angrywasp/Modbot.Tank/README.md

# Modbot.Tank
Project to build an RC tank based on the Modbot system
