angrywasp/Modbot.Tank/Models/Export/BatteryHolder.stl

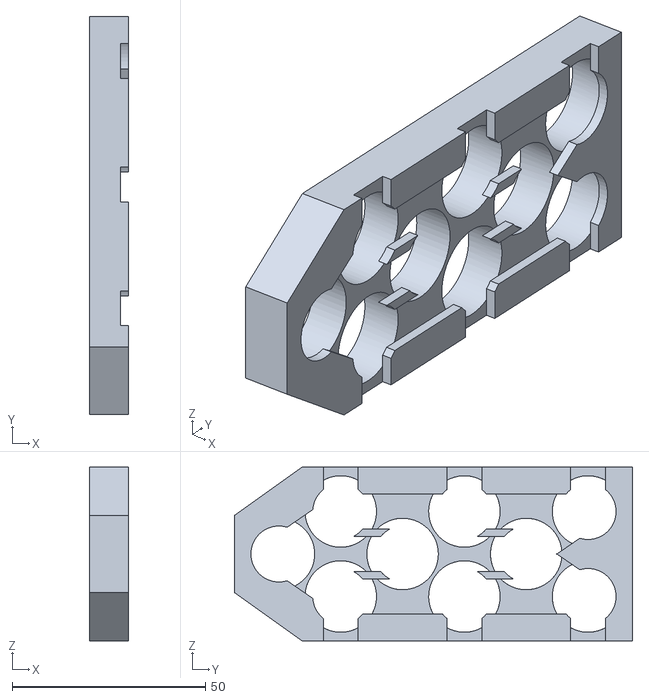
[picture p1: CAD file, 2026-05-19]
Models/Export/BatteryHolder.stl
10.0 x 103.0 x 45.0
