angrywasp/Modbot.Tank/Models/Export/TransmitterBody.stl

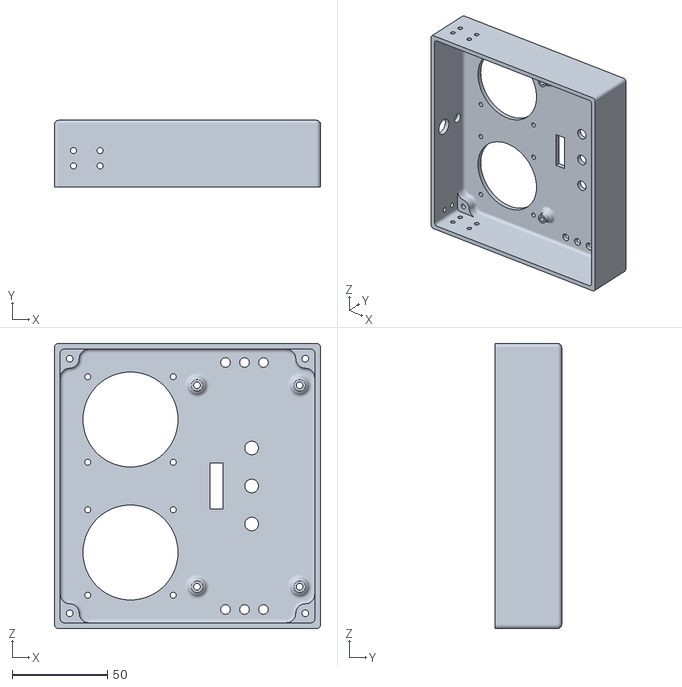
[picture p2: CAD file, 2026-05-19]
Models/Export/TransmitterBody.stl
140.0 x 35.0 x 150.0
