angrywasp/Modbot.Tank/Models/Export/ESPDevBoard.stl

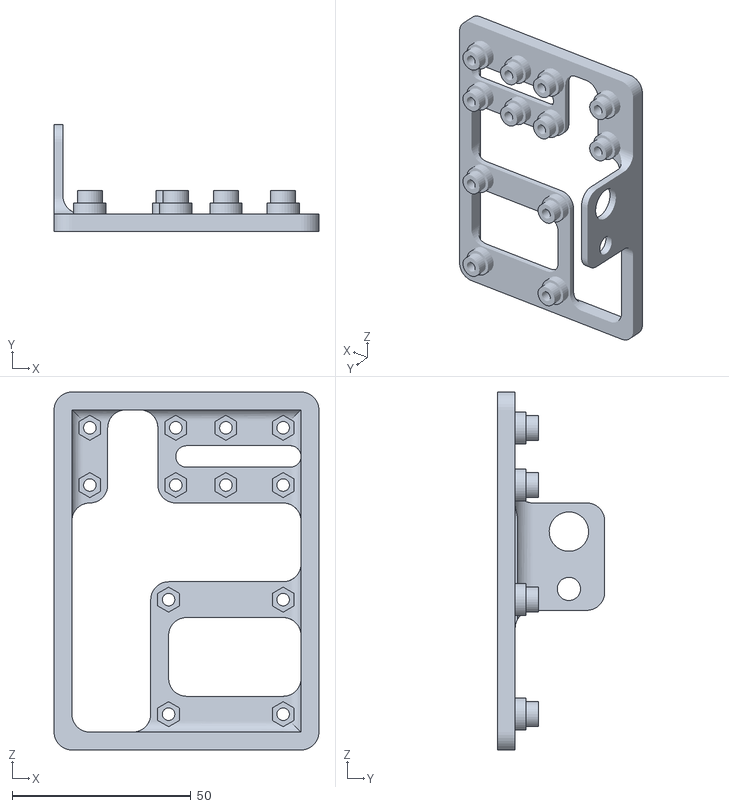
[picture p3: CAD file, 2026-05-19]
Models/Export/ESPDevBoard.stl
74.0 x 30.0 x 100.0
