angrywasp/Modbot.Tank/Models/Export/NrfMount.stl

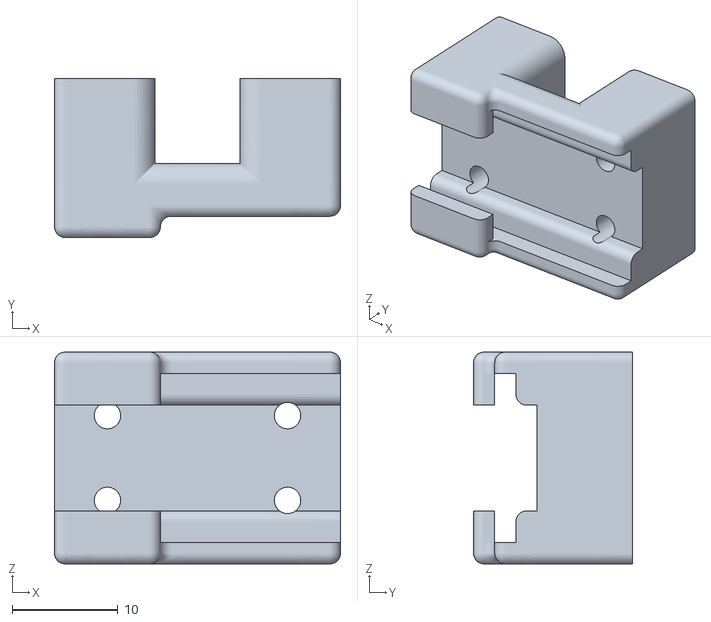
[picture p4: CAD file, 2026-05-19]
Models/Export/NrfMount.stl
27.0 x 15.0 x 20.0
