angrywasp/Modbot.Tank/Models/Export/TransmitterBack.stl

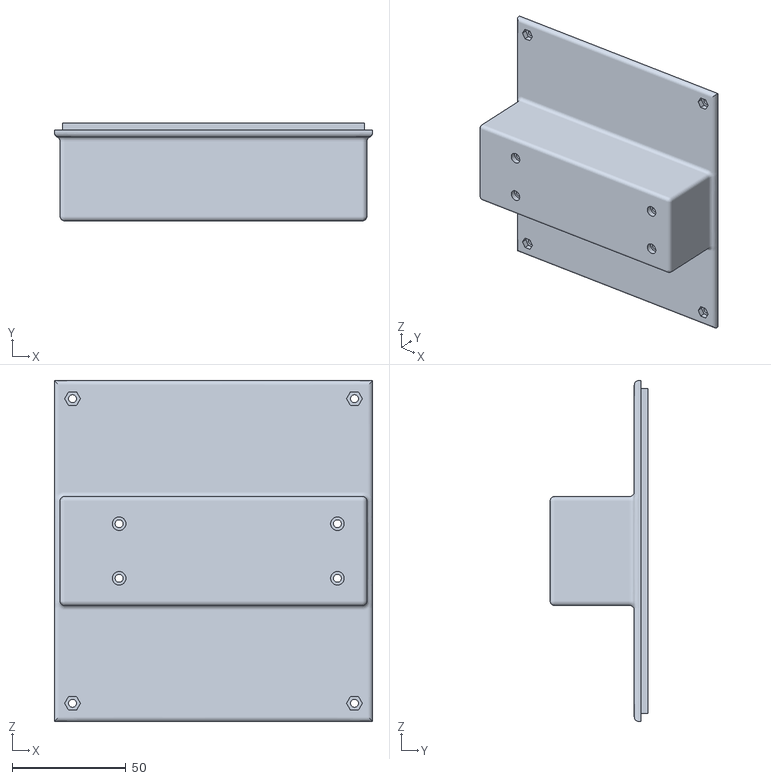
[picture p5: CAD file, 2026-05-19]
Models/Export/TransmitterBack.stl
140.0 x 43.0 x 150.0
