angrywasp/Modbot.Tank/Models/Export/BatteryHolder2PBase.stl

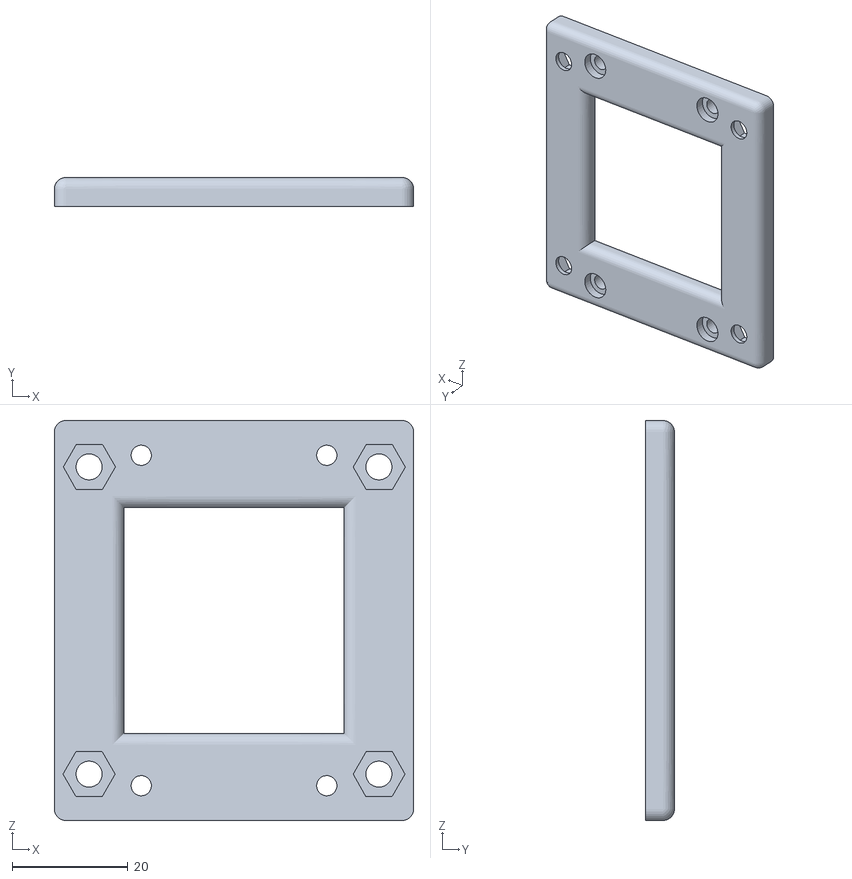
[picture p6: CAD file, 2026-05-19]
Models/Export/BatteryHolder2PBase.stl
62.0 x 5.00 x 69.0
