angrywasp/Modbot.Tank/Models/Export/PcbSpacer3x6mm.stl

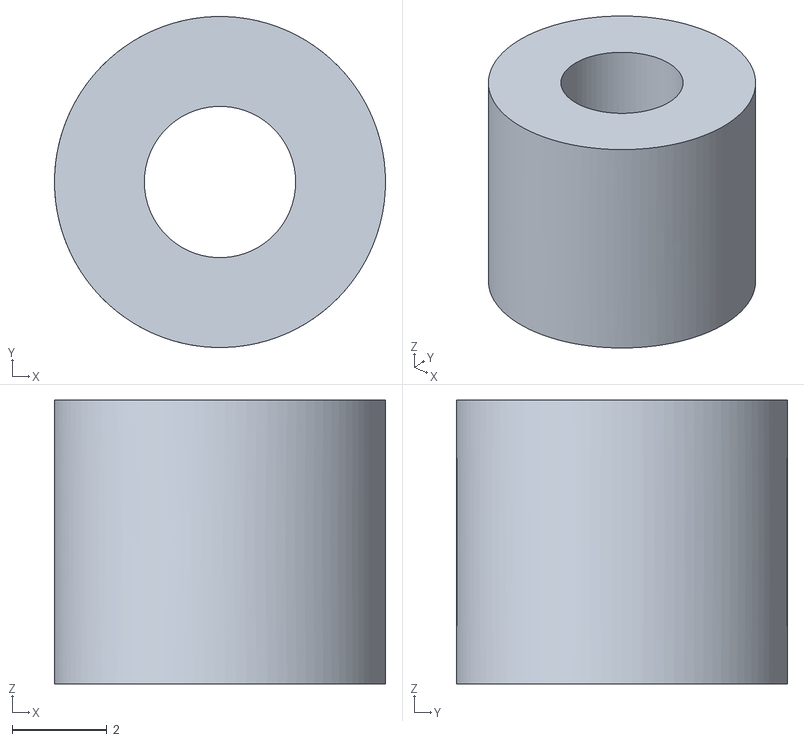
[picture p7: CAD file, 2026-05-19]
Models/Export/PcbSpacer3x6mm.stl
7.00 x 7.00 x 6.00
