angrywasp/Modbot.Tank/Models/Export/PowerBoard.stl

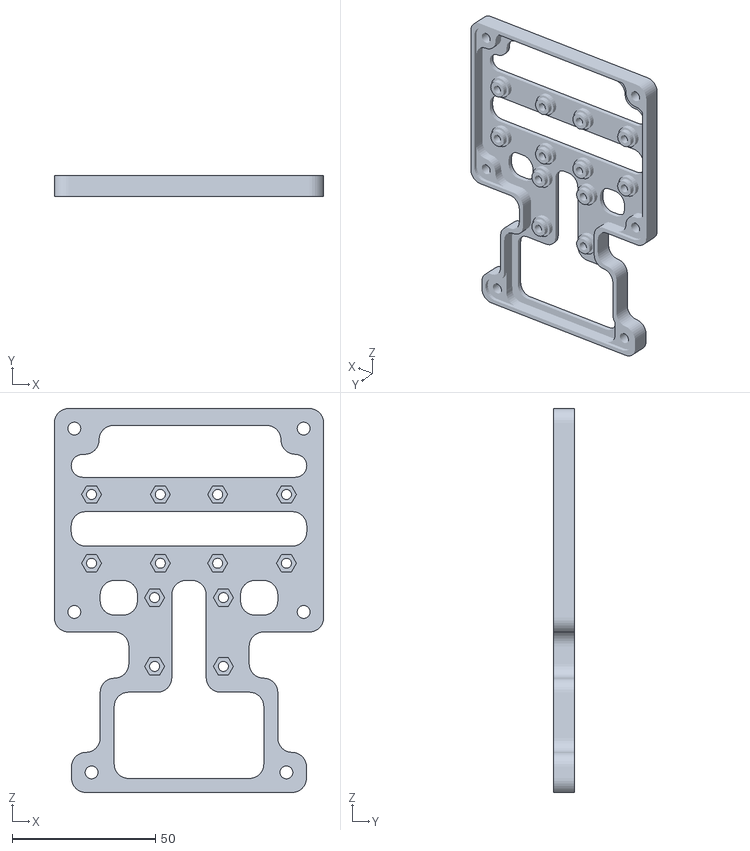
[picture p8: CAD file, 2026-05-19]
Models/Export/PowerBoard.stl
94.0 x 7.50 x 134.0
