angrywasp/Modbot.Tank/Models/Export/PcbSpacer4x5mm.stl

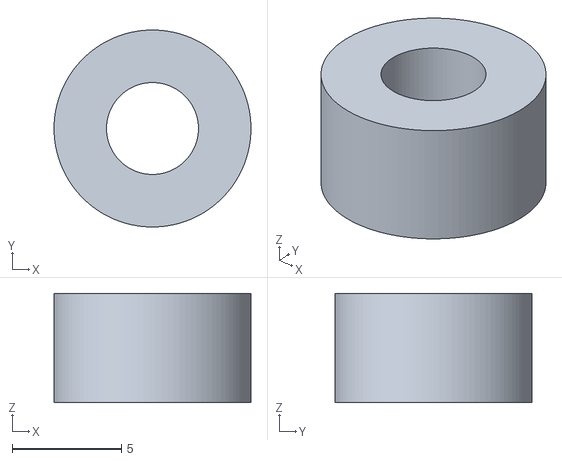
[picture p9: CAD file, 2026-05-19]
Models/Export/PcbSpacer4x5mm.stl
9.00 x 9.00 x 5.00
