angrywasp/Modbot.Tank/Models/Export/BatteryHolder2P.stl

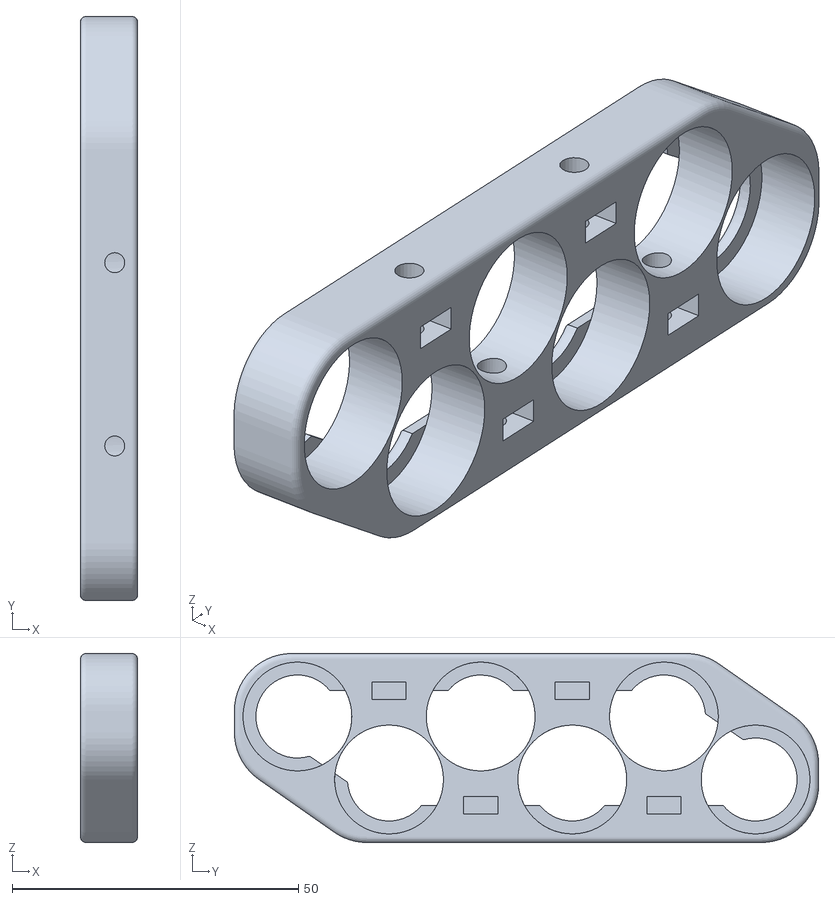
[picture p10: CAD file, 2026-05-19]
Models/Export/BatteryHolder2P.stl
10.0 x 102.0 x 33.0
