angrywasp/Modbot.Tank/Models/Export/BatteryHolder2PTop.stl

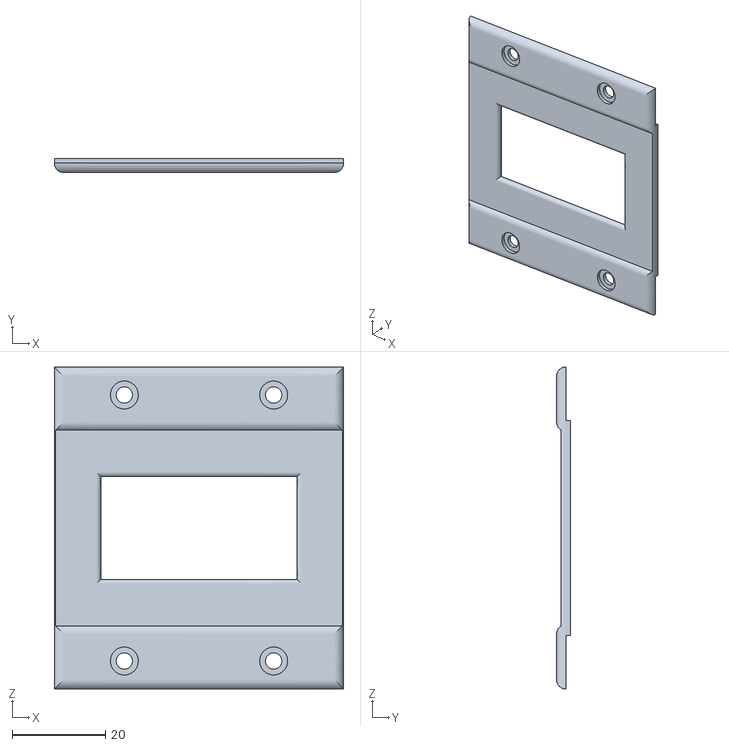
[picture p11: CAD file, 2026-05-19]
Models/Export/BatteryHolder2PTop.stl
62.0 x 3.00 x 69.0
