angrywasp/Modbot.Tank/(list of files, cad)

Other CAD files:
Models/AntennaMast.ipt
Models/AntennaMast65mm.ipt
Models/AntennaMast80mm.ipt
Models/AntennaMount.ipt
Models/BatteryHolder2P.ipt
Models/BatteryHolder2PBase.ipt
Models/BatteryHolder2PTop.ipt
Models/ESPDevBoard.ipt
Models/FpvBoardMount.ipt
Models/FpvScreenMount.ipt
Models/NrfMount.ipt
Models/PanTiltMount.ipt
Models/PcbSpacer3x3mm.ipt
Models/PcbSpacer3x6mm.ipt
Models/PcbSpacer4x20mm.ipt
Models/PcbSpacer4x5mm.ipt
Models/PowerBoardMount.ipt
Models/PowerPlugMountSlim.ipt
Models/RxBoardMount.ipt
Models/RxBoardMountFoot.ipt
Models/RxBoardMountFootWithNut.ipt
Models/SwitchMount.ipt
Models/SwitchMountTop.ipt
Models/TransmitterBack.ipt
Models/TransmitterBody.ipt
Models/TxBoardMount.ipt
