angrywasp/Modbot.Tank/Hardware/TxInputBoard/TxInputBoard.kicad_pcb

## KiCad design Hardware/TxInputBoard/TxInputBoard.kicad_pcb (2026-05-19)

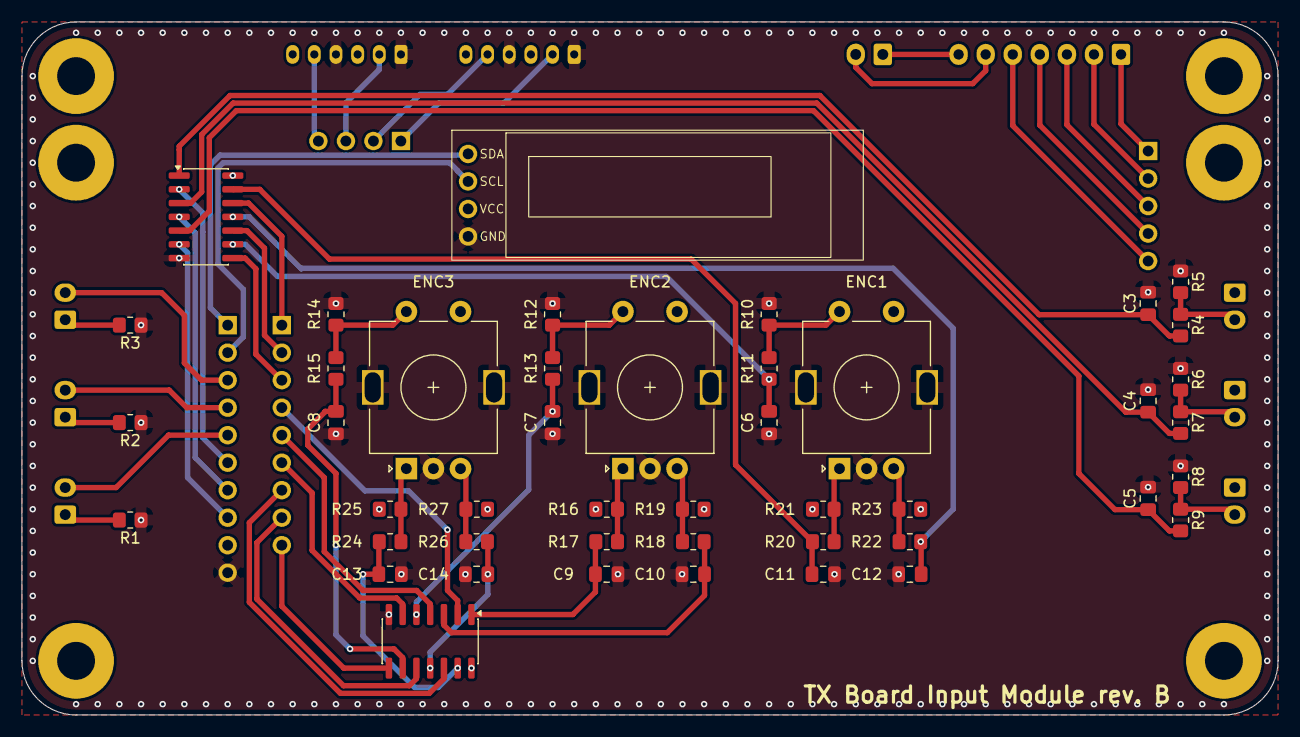
[picture p12: board TxInputBoard.kicad_pcb from above]

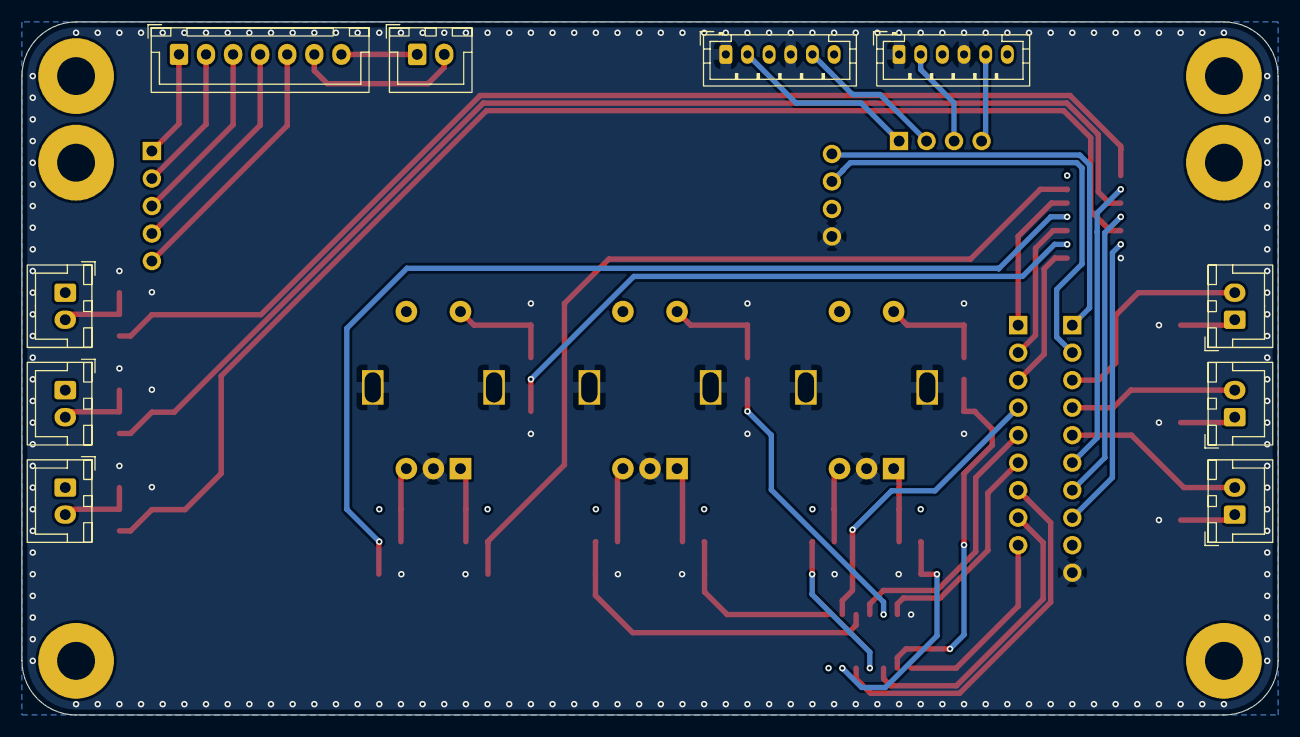
[picture p13: board TxInputBoard.kicad_pcb from below]

Board: 4 copper layers, 116.0 x 64.0 mm, 56 parts (11 on the bottom side), 57 nets.

Parts:
C3, C4, C5, C6, C7, C8, C9, C10, C11, C12, C13, C14: 0.1uF; C_0805_2012Metric_Pad1.18x1.45mm_HandSolder
ENC1, ENC2, ENC3: RotaryEncoder_Switch_MP; RotaryEncoder_Alps_EC11E-Switch_Vertical_H20mm
J4: L Joy; JST_PH_B6B-PH-K_1x06_P2.00mm_Vertical
J5: R Joy; JST_PH_B6B-PH-K_1x06_P2.00mm_Vertical
J8: OLED; SSD1306_OLED_128x32
JSwitch1: Conn_01x02; JST_XH_B2B-XH-A_1x02_P2.50mm_Vertical
L1, L2, L3: Green; JST_XH_B2B-XH-A_1x02_P2.50mm_Vertical
R1, R2, R3: 330; R_0805_2012Metric_Pad1.20x1.40mm_HandSolder
R4, R7, R9, R11, R13, R15: 1k; R_0805_2012Metric_Pad1.20x1.40mm_HandSolder
R5, R6, R8, R10, R12, R14, R16, R17, R18, R19, R20, R21, R22, R23, R24, R25, R26, R27: 10k; R_0805_2012Metric_Pad1.20x1.40mm_HandSolder
SW1, SW2, SW3: SW_SPST; JST_XH_B2B-XH-A_1x02_P2.50mm_Vertical
U1, U2: 74HC14; SO-14_3.9x8.65mm_P1.27mm
U3: MCP73831_18650Charger; JST_XH_B7B-XH-A_1x07_P2.50mm_Vertical
U4: MiniTx; TXBoardMini

Connections:
+3.3V: ENC1.S1, ENC2.S1, ENC3.S1, J4.3, J4.6, J5.3, J5.6, J8.3, R16.2, R19.2, R21.2, R23.2, R25.2, R27.2, SW1.1 (A), SW2.1 (A), SW3.1 (A), U1.14 (VCC), U2.14 (VCC), U4.18 (3v3)
CMP: U3.3 (CMP), U4.22 (CMP)
ENC1_A: U1.12, U4.1 (E1A)
ENC1_B: U1.10, U4.2 (E1B)
ENC1_SW: U1.8, U4.3 (E1SW)
ENC2_A: U2.2, U4.4 (E2A)
ENC2_B: U2.4, U4.5 (E2B)
ENC2_SW: U2.6, U4.6 (E2SW)
ENC3_A: U2.12, U4.7 (E3A)
ENC3_B: U2.10, U4.8 (E3B)
ENC3_SW: U2.8, U4.9 (E3SW)
GND: C3.2, C4.2, C5.2, C6.2, C7.2, C8.2, C9.2, C10.2, C11.2, C12.2, C13.2, C14.2, ENC1.C, ENC1.MP, ENC2.C, ENC2.MP, ENC3.C, ENC3.MP, J4.1, J4.4, J5.1, J5.4, J8.4, R1.1, R2.1, R3.1, R5.1, R6.1, R8.1, R10.1, R12.1, R14.1, U1.7 (GND), U2.7 (GND), U4.19 (GND)
IN+: U3.1 (IN+), U4.20 (IN+)
IN-: U3.2 (IN-), U4.21 (IN-)
LED_1: L1.2 (A), U4.14 (LED1)
LED_2: L2.2 (A), U4.13 (LED2)
LED_3: L3.2 (A), U4.12 (LED3)
LJOY1: J4.2, U4.25 (A1)
LJOY2: J4.5, U4.26 (A2)
unnamed: C3.1, R4.2, U1.1
unnamed: C4.1, R7.2, U1.3
unnamed: C5.1, R9.2, U1.5
unnamed: C6.1, R11.2, U1.9
unnamed: C7.1, R13.2, U2.5
unnamed: C8.1, R15.2, U2.9
unnamed: C9.1, R17.2, U2.1
unnamed: C10.1, R18.2, U2.3
unnamed: C11.1, R20.2, U1.13
unnamed: C12.1, R22.2, U1.11
unnamed: C13.1, R24.2, U2.13
unnamed: C14.1, R26.2, U2.11
unnamed: ENC1.A, R20.1, R21.1
unnamed: ENC1.B, R22.1, R23.1
unnamed: ENC1.S2, R10.2, R11.1
unnamed: ENC2.A, R16.1, R17.1
unnamed: ENC2.B, R18.1, R19.1
unnamed: ENC2.S2, R12.2, R13.1
unnamed: ENC3.A, R24.1, R25.1
unnamed: ENC3.B, R26.1, R27.1
unnamed: ENC3.S2, R14.2, R15.1
unnamed: JSwitch1.1, U3.7 (SW)
unnamed: JSwitch1.2, U3.6 (SW)
unnamed: L1.1 (K), R1.2
unnamed: L2.1 (K), R2.2
unnamed: L3.1 (K), R3.2
unnamed: R4.1, R5.2, SW1.2 (B)
unnamed: R6.2, R7.1, SW2.2 (B)
unnamed: R8.2, R9.1, SW3.2 (B)
OLED_SCL: J8.2, U4.11 (OLED_SCL)
OLED_SDA: J8.1, U4.10 (OLED_SDA)
OUT+: U3.5 (OUT+), U4.24 (OUT+)
OUT-: U3.4 (OUT-), U4.23 (OUT-)
RJOY1: J5.2, U4.27 (A3)
RJOY2: J5.5, U4.28 (A4)
SW1: U1.2, U4.15 (SW1)
SW2: U1.4, U4.16 (SW2)
SW3: U1.6, U4.17 (SW3)
