angrywasp/Modbot.Tank/Hardware/TxBoardMini/TxBoardMini.kicad_pcb

## KiCad design Hardware/TxBoardMini/TxBoardMini.kicad_pcb (2026-05-19)

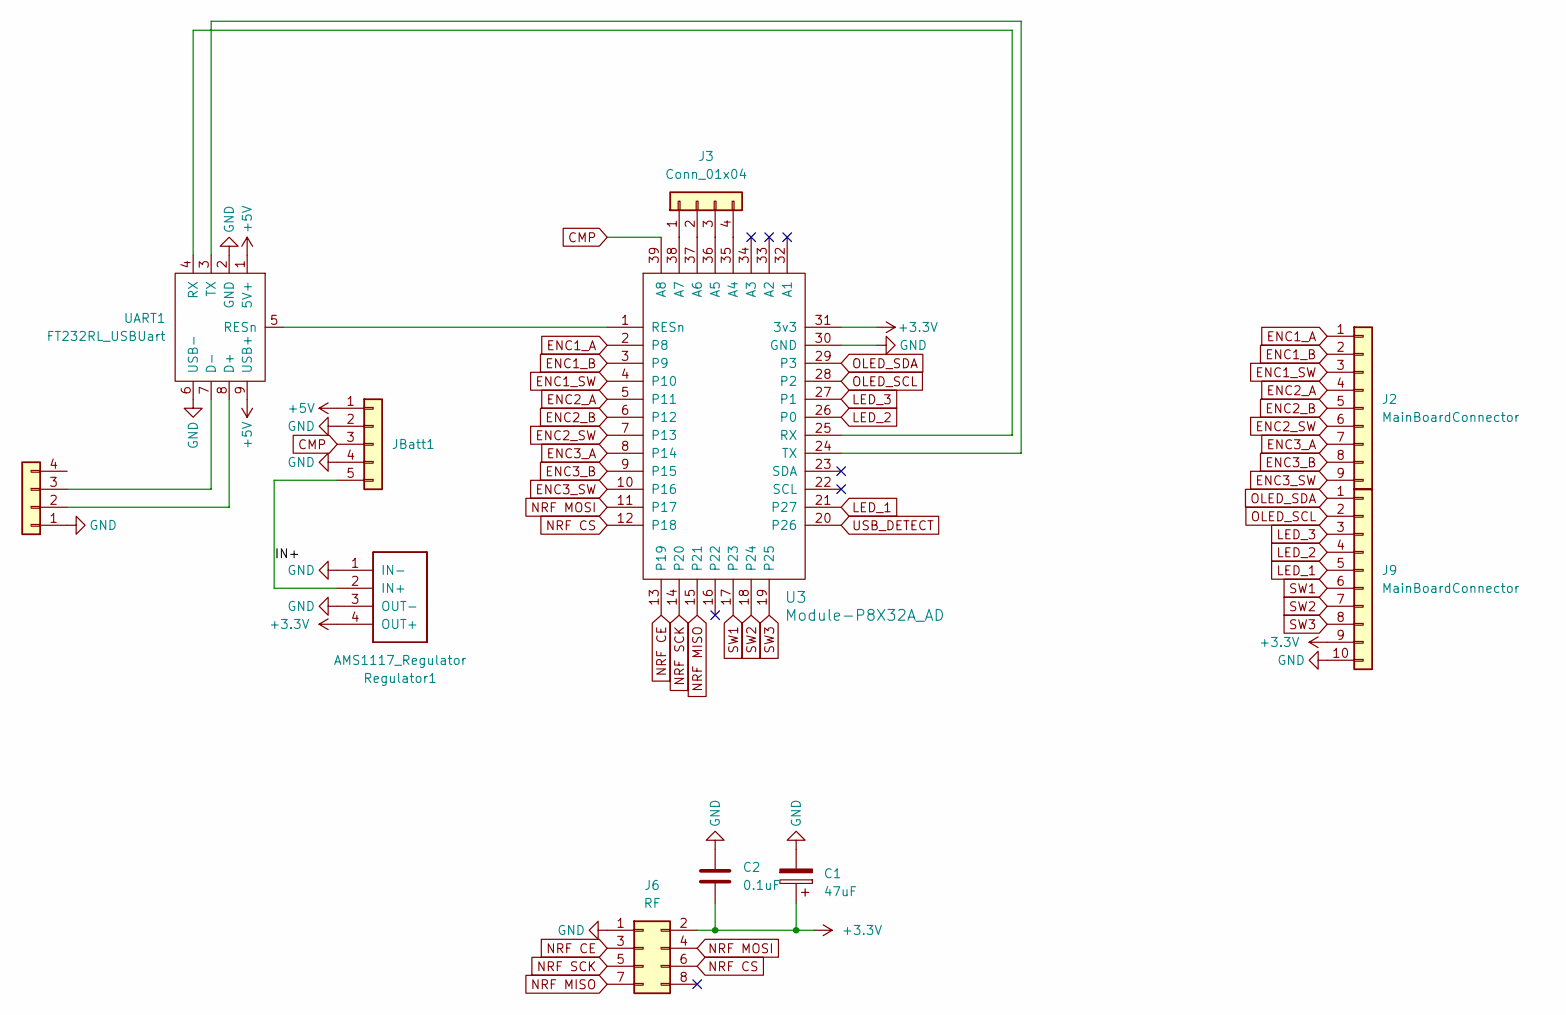
[picture p14: schematic TxBoardMini.kicad_sch]

Parts:
C1: 47uF; CP_Elec_5x5.3
C2: 0.1uF; C_0805_2012Metric_Pad1.18x1.45mm_HandSolder
J1: USB; JST_PH_B4B-PH-K_1x04_P2.00mm_Vertical
J2: MainBoardConnector; PinHeader_1x09_P2.54mm_Vertical
J3: Conn_01x04; PinHeader_1x04_P2.54mm_Vertical
J6: RF; PinHeader_2x04_P2.54mm_Vertical
J9: MainBoardConnector; PinHeader_1x10_P2.54mm_Vertical
JBatt1: Conn_01x05; PinHeader_1x05_P2.54mm_Vertical
Regulator1: AMS1117_Regulator; Module-SOT-223_TO-252-3_Regulator
U3: Module-P8X32A_AD
UART1: FT232RL_USBUart; Module-FT232RL_USBUart

Connections:
+3.3V: C1.1, C2.2, J6.2, J9.9, Regulator1.4 (OUT+), U3.31 (3v3)
+5V: JBatt1.1, UART1.1 (5V+), UART1.9 (USB+)
/IN+: JBatt1.5, Regulator1.2 (IN+)
CMP: JBatt1.3, U3.39 (A8)
ENC1_A: J2.1, U3.2 (P8)
ENC1_B: J2.2, U3.3 (P9)
ENC1_SW: J2.3, U3.4 (P10)
ENC2_A: J2.4, U3.5 (P11)
ENC2_B: J2.5, U3.6 (P12)
ENC2_SW: J2.6, U3.7 (P13)
ENC3_A: J2.7, U3.8 (P14)
ENC3_B: J2.8, U3.9 (P15)
ENC3_SW: J2.9, U3.10 (P16)
GND: C1.2, C2.1, J1.1, J6.1, J9.10, JBatt1.2, JBatt1.4, Regulator1.1 (IN-), Regulator1.3 (OUT-), U3.30 (GND), UART1.2 (GND), UART1.6 (USB-)
LED_1: J9.5, U3.21 (P27)
LED_2: J9.4, U3.26 (P0)
LED_3: J9.3, U3.27 (P1)
NRF CE: J6.3, U3.13 (P19)
NRF CS: J6.6, U3.12 (P18)
NRF MISO: J6.7, U3.15 (P21)
NRF MOSI: J6.4, U3.11 (P17)
NRF SCK: J6.5, U3.14 (P20)
unnamed: J1.2, UART1.8 (D+)
unnamed: J1.3, UART1.7 (D-)
unnamed: J3.1, U3.38 (A7)
unnamed: J3.2, U3.37 (A6)
unnamed: J3.3, U3.36 (A5)
unnamed: J3.4, U3.35 (A4)
unnamed: U3.1 (RESn), UART1.5 (RESn)
unnamed: U3.25 (RX), UART1.4 (RX)
unnamed: U3.24 (TX), UART1.3 (TX)
OLED_SCL: J9.2, U3.28 (P2)
OLED_SDA: J9.1, U3.29 (P3)
SW1: J9.6, U3.17 (P23)
SW2: J9.7, U3.18 (P24)
SW3: J9.8, U3.19 (P25)
USB_DETECT: U3.20 (P26)

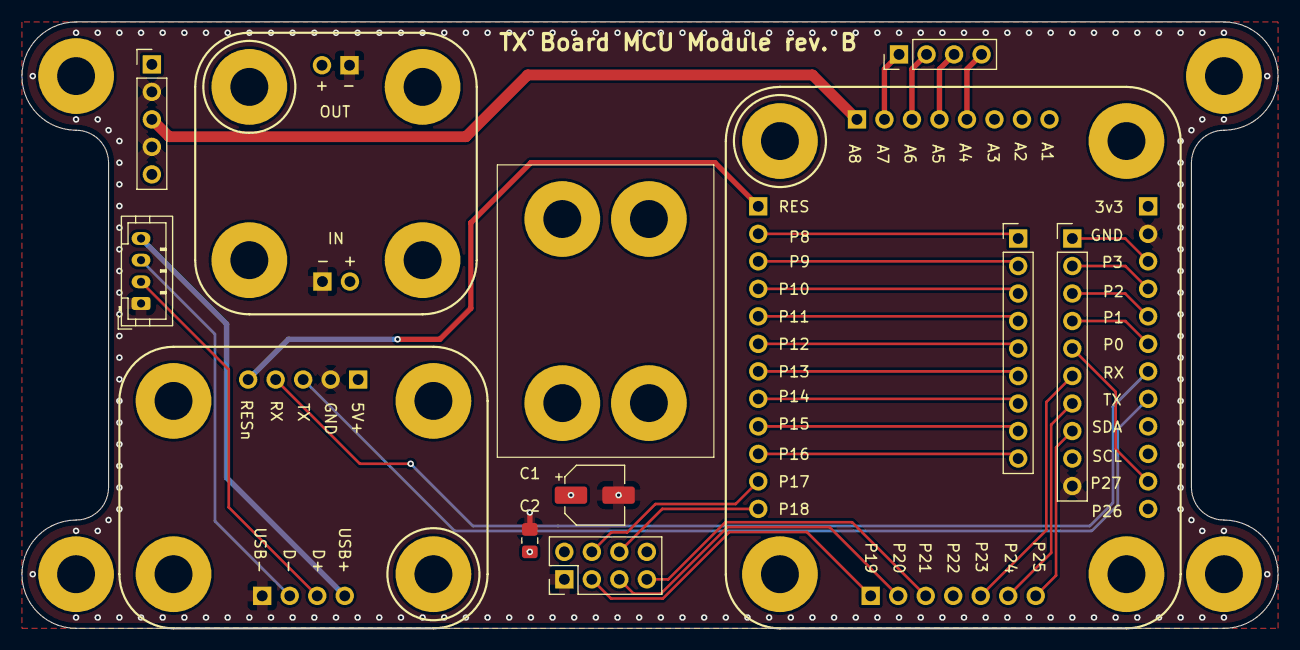
[picture p15: board TxBoardMini.kicad_pcb from above]

Board: 4 copper layers, 116.0 x 56.0 mm, 11 parts (0 on the bottom side), 36 nets.
