angrywasp/Modbot.Tank/Hardware/RxBoard/RxBoard.kicad_pcb

## KiCad design Hardware/RxBoard/RxBoard.kicad_pcb (2026-05-19)

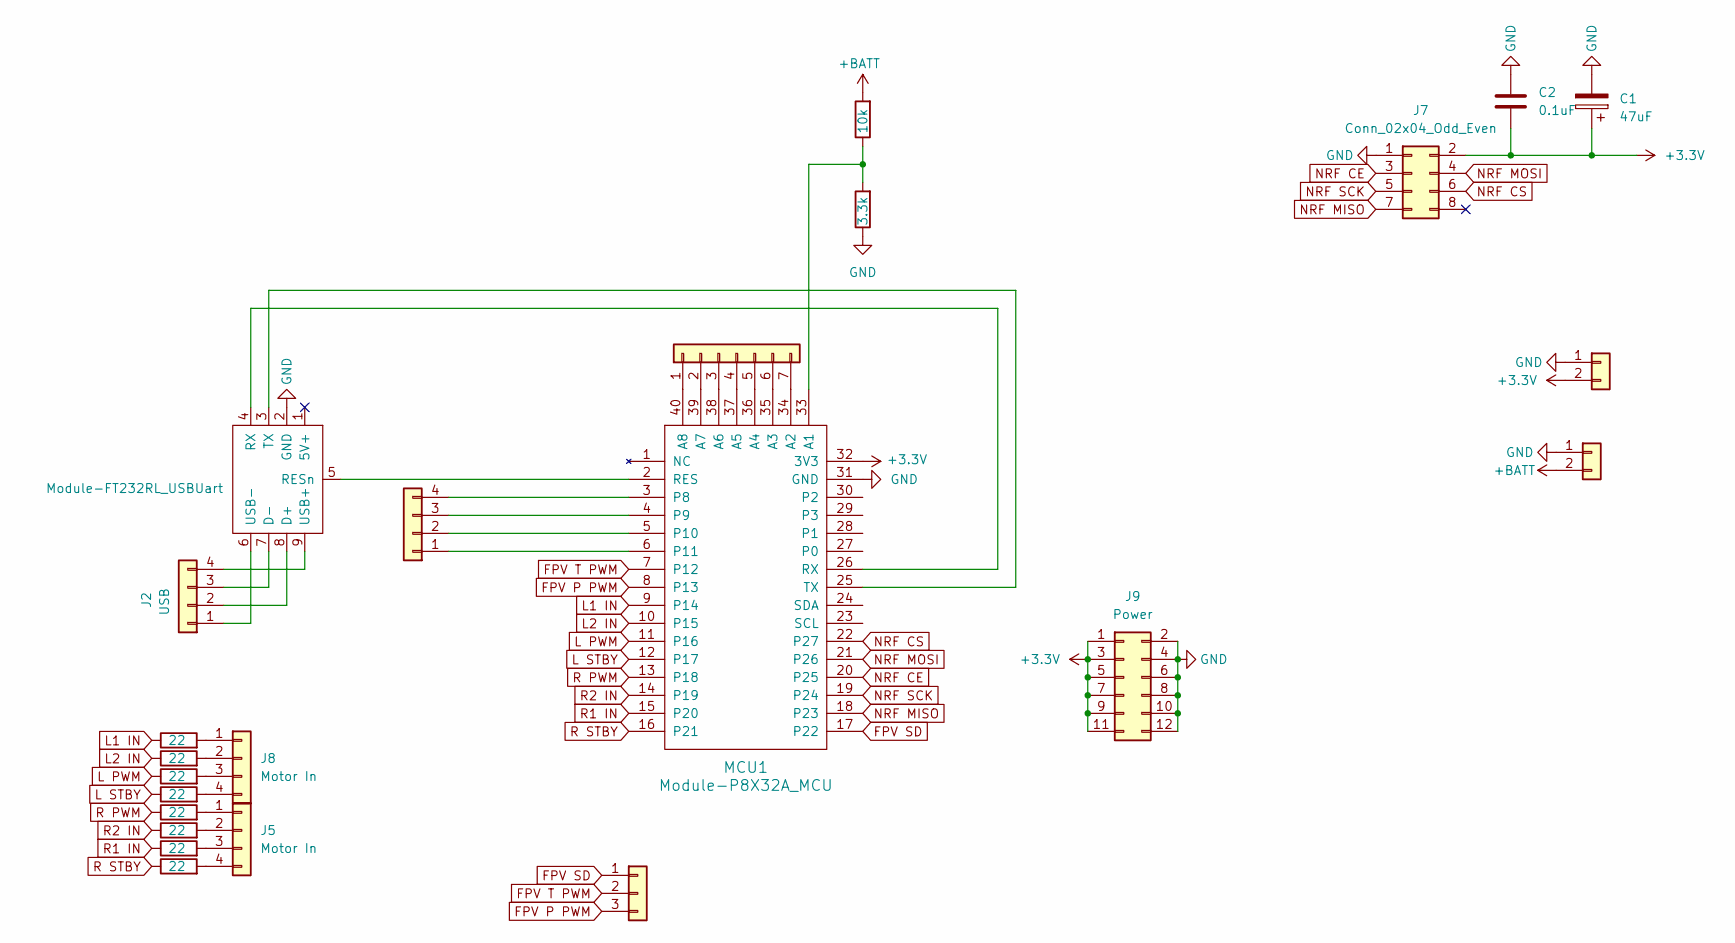
[picture p16: schematic RxBoard.kicad_sch]

Parts:
C1: 47uF; CP_Elec_5x5.3
C2: 0.1uF; C_0805_2012Metric_Pad1.18x1.45mm_HandSolder
J1: Conn_01x04; JST_XH_B3B-XH-A_1x03_P2.50mm_Vertical
J2: USB; JST_PH_B4B-PH-K_1x04_P2.00mm_Vertical
J3: Conn_01x09; PinHeader_1x04_P2.54mm_Vertical
J4: Conn_01x08; PinHeader_1x07_P2.54mm_Vertical
J5, J8: Motor In; JST_XH_B4B-XH-A_1x04_P2.50mm_Vertical
J7: Conn_02x04_Odd_Even; PinHeader_2x04_P2.54mm_Vertical
J9: Power; PinHeader_2x06_P2.54mm_Vertical
J10, J11: Conn_01x02; AMASS_XT30UPB-M_1x02_P5.0mm_Vertical
MCU1: Module-P8X32A_MCU
R1, R2, R3, R4, R5, R6, R7, R8: 22; R_0805_2012Metric_Pad1.20x1.40mm_HandSolder
R9: 10k; R_0805_2012Metric_Pad1.20x1.40mm_HandSolder
R10: 3.3k; R_0805_2012Metric_Pad1.20x1.40mm_HandSolder
UART1: Module-FT232RL_USBUart

Connections:
+3.3V: C1.1, C2.2, J7.2, J9.1, J9.3, J9.5, J9.7, J9.9, J9.11, J11.2, MCU1.32 (3V3)
+BATT: J10.2, R9.2
FPV P PWM: J1.3, MCU1.8 (P13)
FPV SD: J1.1, MCU1.17 (P22)
FPV T PWM: J1.2, MCU1.7 (P12)
GND: C1.2, C2.1, J7.1, J9.2, J9.4, J9.6, J9.8, J9.10, J9.12, J10.1, J11.1, MCU1.31 (GND), R10.1, UART1.2 (GND)
L1 IN: MCU1.9 (P14), R1.1
L2 IN: MCU1.10 (P15), R2.1
L PWM: MCU1.11 (P16), R3.1
L STBY: MCU1.12 (P17), R4.1
NRF CE: J7.3, MCU1.20 (P25)
NRF CS: J7.6, MCU1.22 (P27)
NRF MISO: J7.7, MCU1.18 (P23)
NRF MOSI: J7.4, MCU1.21 (P26)
NRF SCK: J7.5, MCU1.19 (P24)
unnamed: J2.1, UART1.6 (USB-)
unnamed: J2.2, UART1.8 (D+)
unnamed: J2.3, UART1.7 (D-)
unnamed: J2.4, UART1.9 (USB+)
unnamed: J3.1, MCU1.6 (P11)
unnamed: J3.2, MCU1.5 (P10)
unnamed: J3.3, MCU1.4 (P9)
unnamed: J3.4, MCU1.3 (P8)
unnamed: J4.1, MCU1.40 (A8)
unnamed: J4.2, MCU1.39 (A7)
unnamed: J4.3, MCU1.38 (A6)
unnamed: J4.4, MCU1.37 (A5)
unnamed: J4.5, MCU1.36 (A4)
unnamed: J4.6, MCU1.35 (A3)
unnamed: J4.7, MCU1.34 (A2)
unnamed: J5.1, R5.2
unnamed: J5.2, R6.2
unnamed: J5.3, R7.2
unnamed: J5.4, R8.2
unnamed: J8.1, R1.2
unnamed: J8.2, R2.2
unnamed: J8.3, R3.2
unnamed: J8.4, R4.2
unnamed: MCU1.33 (A1), R9.1, R10.2
unnamed: MCU1.2 (RES), UART1.5 (RESn)
unnamed: MCU1.26 (RX), UART1.4 (RX)
unnamed: MCU1.25 (TX), UART1.3 (TX)
R1 IN: MCU1.15 (P20), R7.1
R2 IN: MCU1.14 (P19), R6.1
R PWM: MCU1.13 (P18), R5.1
R STBY: MCU1.16 (P21), R8.1

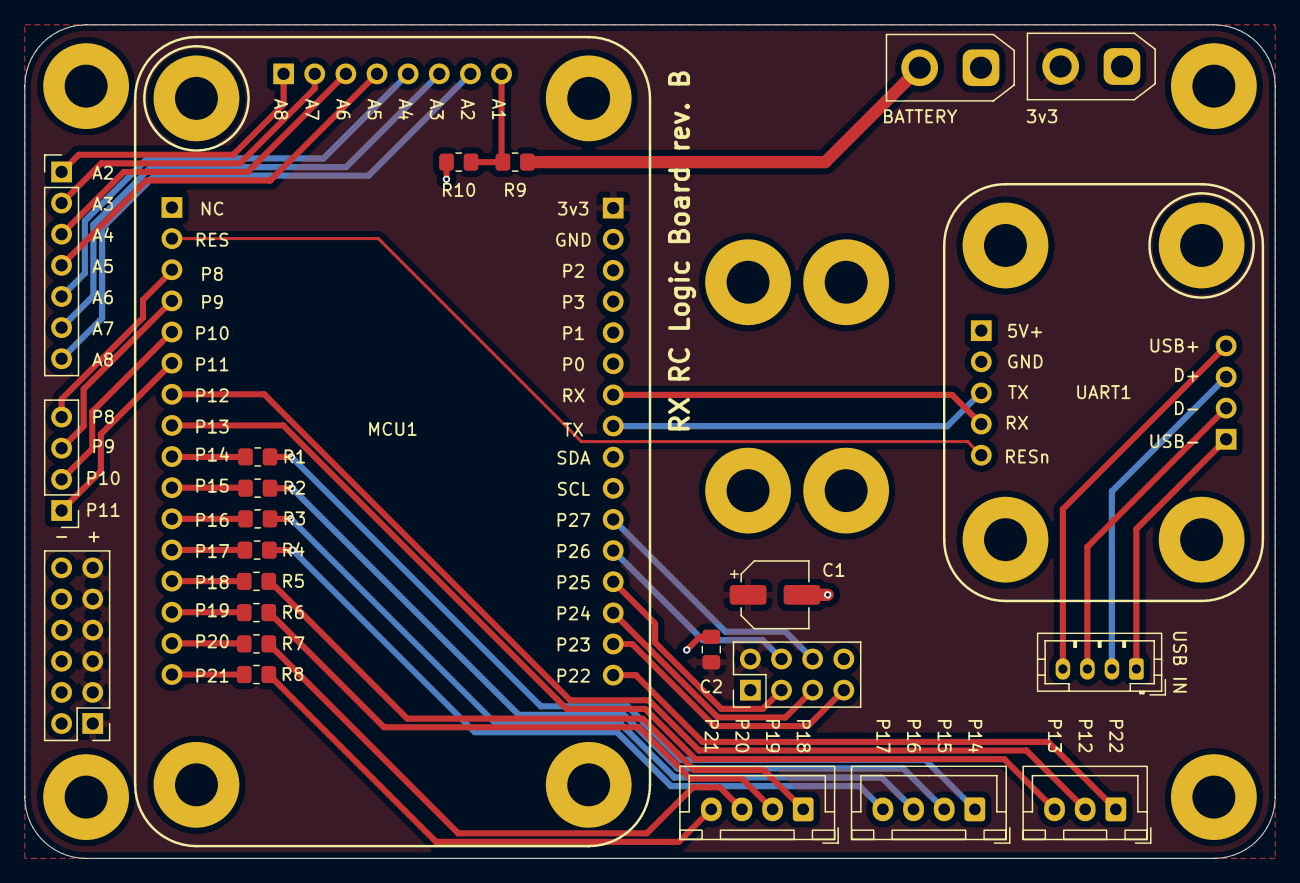
[picture p17: board RxBoard.kicad_pcb from above]

Board: 2 copper layers, 102.0 x 68.0 mm, 24 parts (0 on the bottom side), 46 nets.
