angrywasp/Modbot.Tank/Hardware/PowerBoard/PowerBoard.kicad_pcb

## KiCad design Hardware/PowerBoard/PowerBoard.kicad_pcb (2026-05-19)

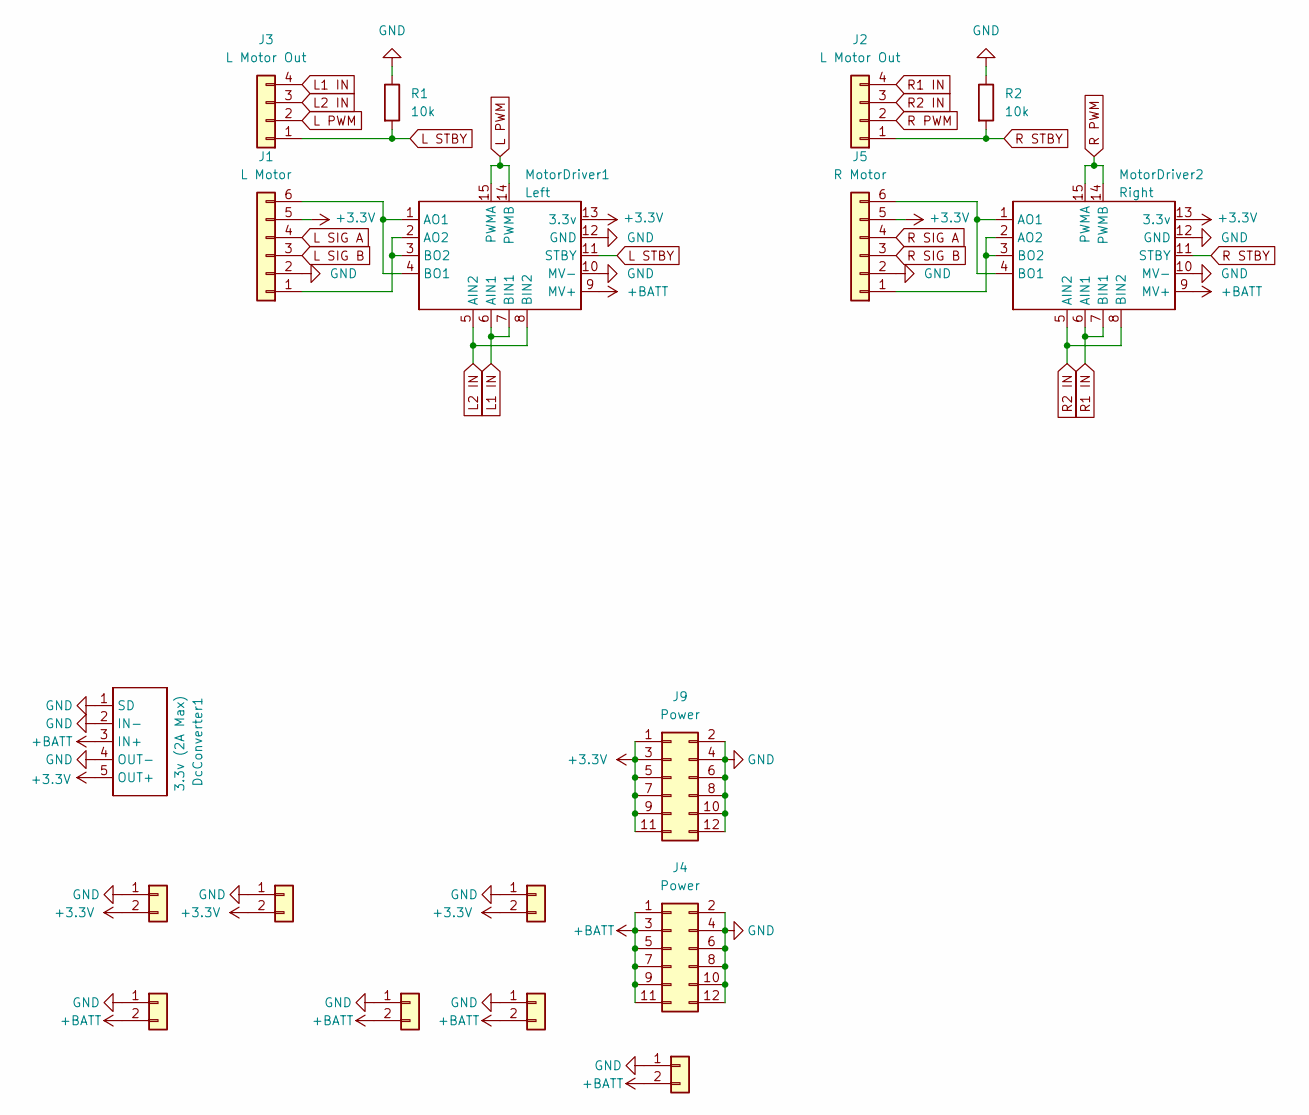
[picture p18: schematic PowerBoard.kicad_sch]

Parts:
DcConverter1: 3.3v (2A Max); Module-AP1509_DcConverter
J1: L Motor; JST_PH_B6B-PH-K_1x06_P2.00mm_Vertical
J2, J3: L Motor Out; JST_XH_B4B-XH-A_1x04_P2.50mm_Vertical
J4, J9: Power; PinHeader_2x06_P2.54mm_Vertical
J5: R Motor; JST_PH_B6B-PH-K_1x06_P2.00mm_Vertical
J7, J10, J12, J17, J18, J20: Conn_01x02; AMASS_XT30UPB-F_1x02_P5.0mm_Vertical
J8: Conn_01x02; AMASS_XT60PW-M_1x02_P7.20mm_Horizontal
MotorDriver1: Left; Module-TB6612FNG_MotorDriver
MotorDriver2: Right; Module-TB6612FNG_MotorDriver
R1, R2: 10k; R_0805_2012Metric_Pad1.20x1.40mm_HandSolder

Connections:
+3.3V: DcConverter1.5 (OUT+), J1.5, J5.5, J7.2, J9.1, J9.3, J9.5, J9.7, J9.9, J9.11, J10.2, J18.2, MotorDriver1.13 (3.3v), MotorDriver2.13 (3.3v)
+BATT: DcConverter1.3 (IN+), J4.1, J4.3, J4.5, J4.7, J4.9, J4.11, J8.2, J12.2, J17.2, J20.2, MotorDriver1.9 (MV+), MotorDriver2.9 (MV+)
GND: DcConverter1.1 (SD), DcConverter1.2 (IN-), DcConverter1.4 (OUT-), J1.2, J4.2, J4.4, J4.6, J4.8, J4.10, J4.12, J5.2, J7.1, J8.1, J9.2, J9.4, J9.6, J9.8, J9.10, J9.12, J10.1, J12.1, J17.1, J18.1, J20.1, MotorDriver1.10 (MV-), MotorDriver1.12 (GND), MotorDriver2.10 (MV-), MotorDriver2.12 (GND), R1.1, R2.1
L1 IN: J3.4, MotorDriver1.6 (AIN1), MotorDriver1.7 (BIN1)
L2 IN: J3.3, MotorDriver1.5 (AIN2), MotorDriver1.8 (BIN2)
L PWM: J3.2, MotorDriver1.14 (PWMB), MotorDriver1.15 (PWMA)
L SIG A: J1.4
L SIG B: J1.3
L STBY: J3.1, MotorDriver1.11 (STBY), R1.2
unnamed: J1.1, MotorDriver1.2 (AO2), MotorDriver1.3 (BO2)
unnamed: J1.6, MotorDriver1.1 (AO1), MotorDriver1.4 (BO1)
unnamed: J5.1, MotorDriver2.2 (AO2), MotorDriver2.3 (BO2)
unnamed: J5.6, MotorDriver2.1 (AO1), MotorDriver2.4 (BO1)
R1 IN: J2.4, MotorDriver2.6 (AIN1), MotorDriver2.7 (BIN1)
R2 IN: J2.3, MotorDriver2.5 (AIN2), MotorDriver2.8 (BIN2)
R PWM: J2.2, MotorDriver2.14 (PWMB), MotorDriver2.15 (PWMA)
R SIG A: J5.4
R SIG B: J5.3
R STBY: J2.1, MotorDriver2.11 (STBY), R2.2

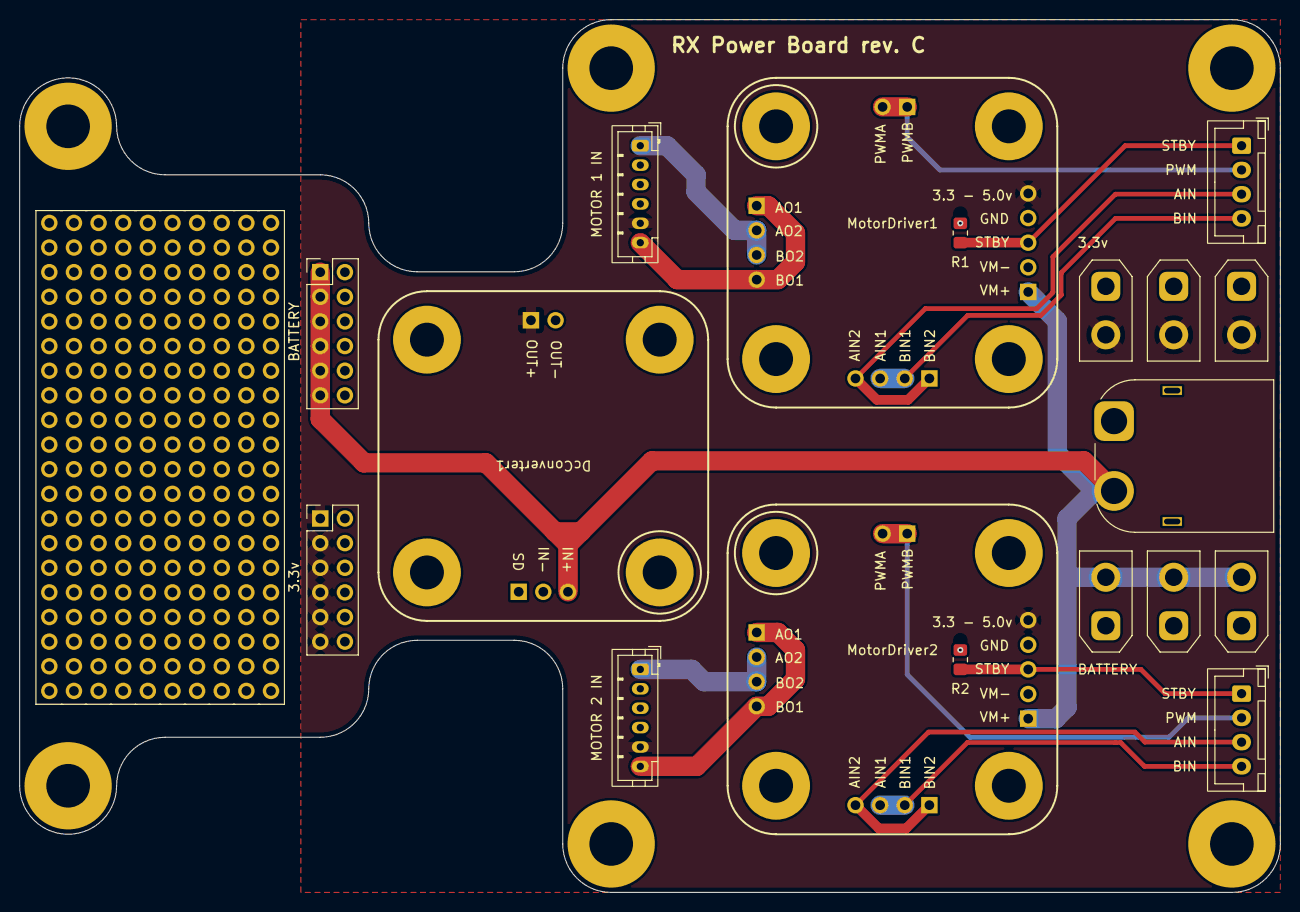
[picture p19: board PowerBoard.kicad_pcb from above]

Board: 2 copper layers, 130.0 x 90.0 mm, 18 parts (0 on the bottom side), 15 nets.
