angrywasp/Modbot.Tank/Hardware/FpvBoard/FpvBoard.kicad_pcb

## KiCad design Hardware/FpvBoard/FpvBoard.kicad_pcb (2026-05-19)

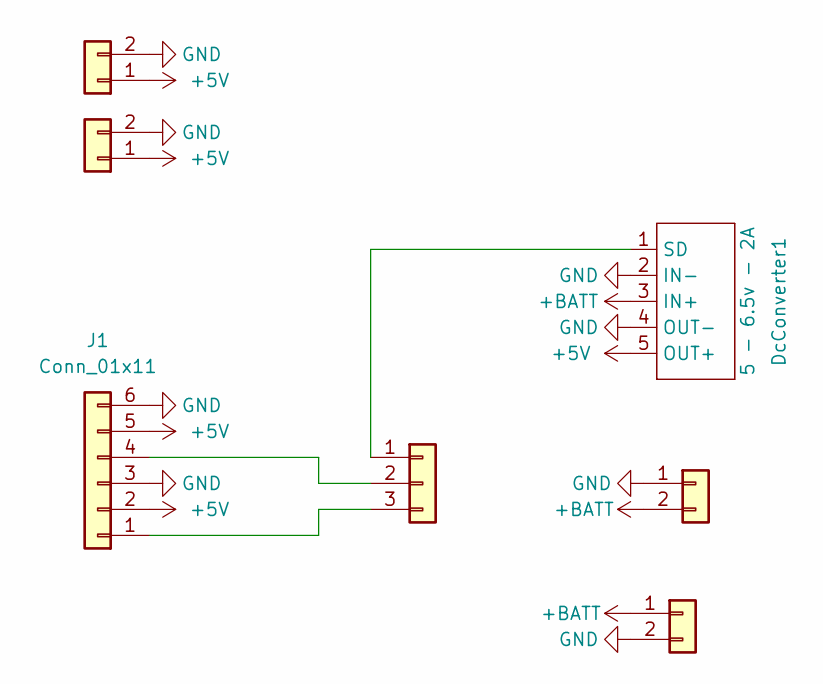
[picture p20: schematic FpvBoard.kicad_sch]

Parts:
DcConverter1: 5 - 6.5v - 2A; Module-AP1509_DcConverter
J1: Conn_01x11; PinHeader_1x06_P2.54mm_Vertical
J2: Conn_01x03; JST_XH_B3B-XH-A_1x03_P2.50mm_Vertical
J3, J4, J5: Conn_01x02; JST_XH_B2B-XH-A_1x02_P2.50mm_Vertical
J8: Conn_01x02; AMASS_XT30UPB-M_1x02_P5.0mm_Vertical

Connections:
+5V: DcConverter1.5 (OUT+), J1.2, J1.5, J4.1, J5.1
+BATT: DcConverter1.3 (IN+), J3.1, J8.2
GND: DcConverter1.2 (IN-), DcConverter1.4 (OUT-), J1.3, J1.6, J3.2, J4.2, J5.2, J8.1
unnamed: DcConverter1.1 (SD), J2.1
unnamed: J1.1, J2.3
unnamed: J1.4, J2.2

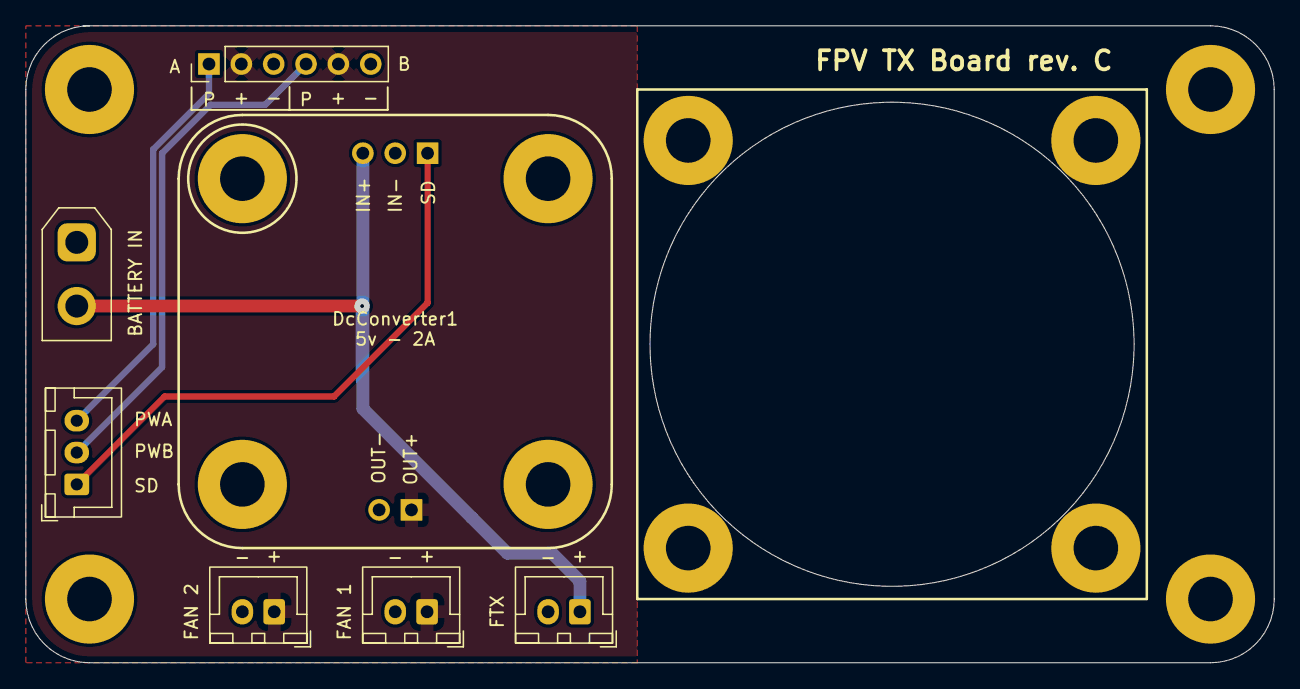
[picture p21: board FpvBoard.kicad_pcb from above]

Board: 2 copper layers, 98.0 x 50.0 mm, 7 parts (0 on the bottom side), 6 nets.
